jigneshamin/cornhole-boards/(list of files, cad)

Other CAD files:
cornhole-board-v2.skp
